tardani95/esp8266-stm32f103c8-ws2811/Documentation/nyak.pdf

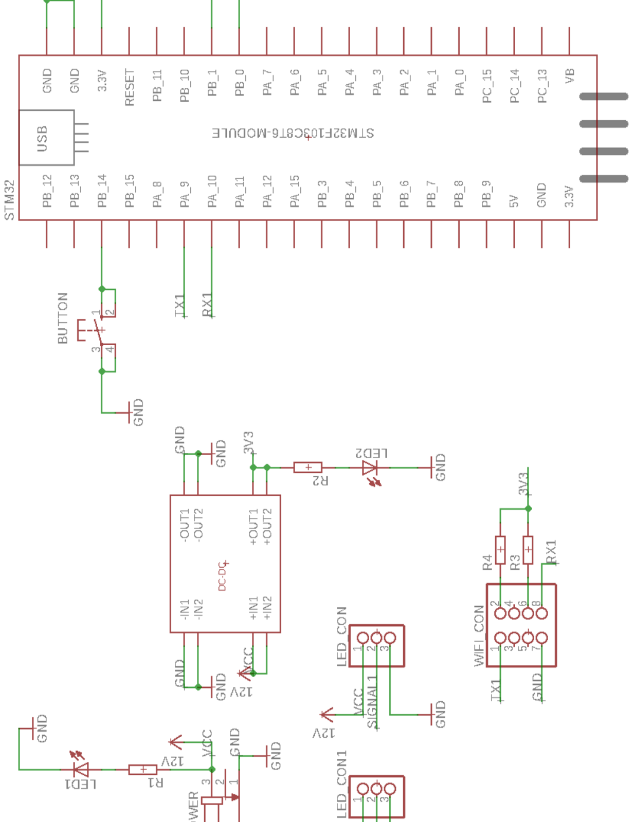
[picture p12: page 1]
