tardani95/esp8266-stm32f103c8-ws2811/doc/esp8266/esp8266_esp01_pinout.png

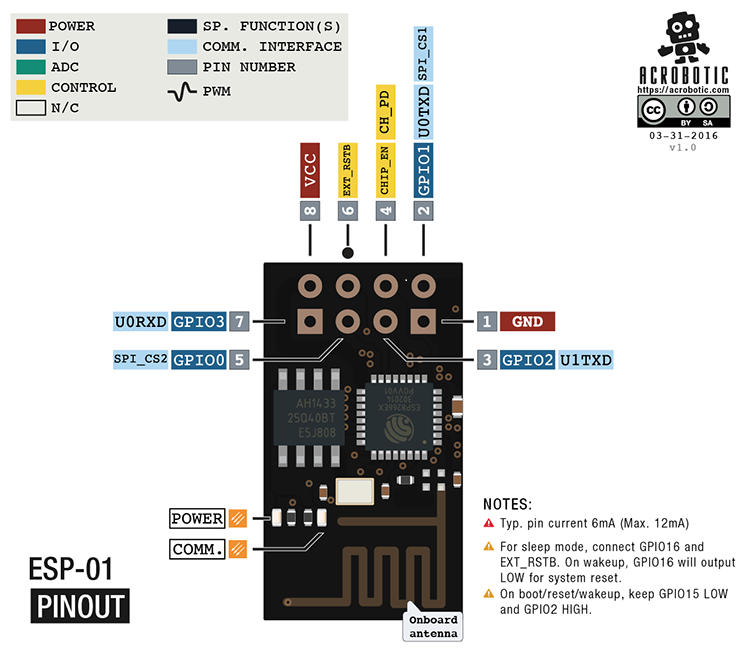
doc/esp8266/esp8266_esp01_pinout.png
