tardani95/esp8266-stm32f103c8-ws2811/doc/stm32f103c8/bd_stm32f103x8_64k.jpg

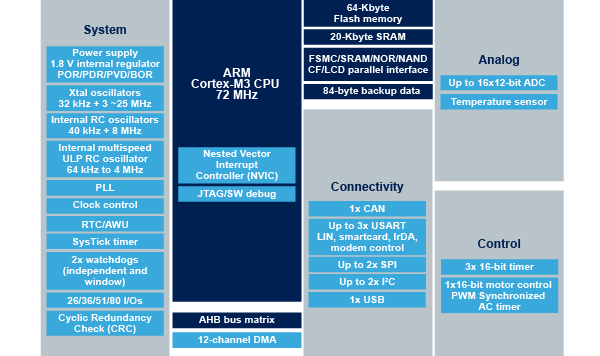
doc/stm32f103c8/bd_stm32f103x8_64k.jpg
