tardani95/esp8266-stm32f103c8-ws2811/doc/stm32f103c8/STM32F103C8.png

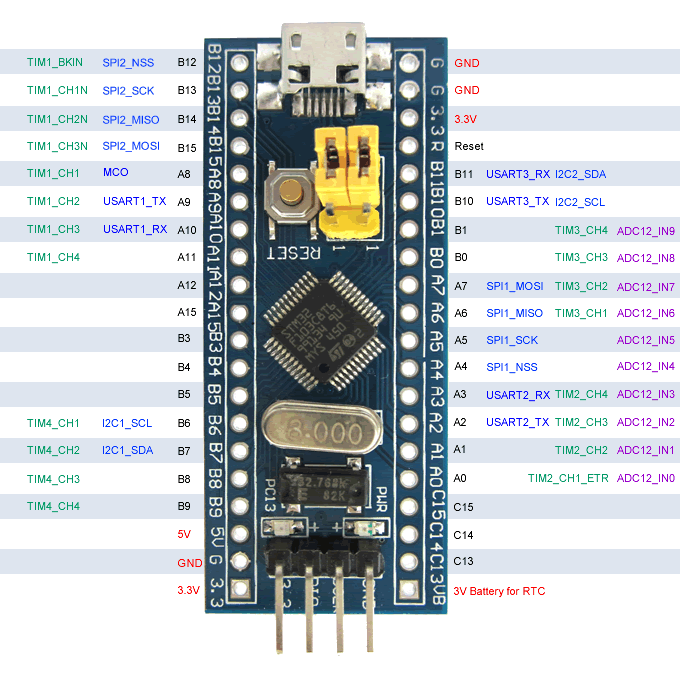
doc/stm32f103c8/STM32F103C8.png
