tardani95/esp8266-stm32f103c8-ws2811/pcb/wifi_ledstrip/bom.xlsx

Sheet: bom_2
 | Total for 4 board | Qty |  | Value | Device | Package | Parts | Description | PROD_ID | SF_ID | SF_SKU | SPICEPREFIX | VALUE
x | 25 | 6 | 0,1u | 100n | C-USC1206 | C1206 | C2, C4, C5, C6, Cbst1,Cbst2 | CAPACITOR, American symbol |  |  |  | C
x | 5 | 1 | 0,01u | 10n | C-USC1206 | C1206 | C9 | CAPACITOR, American symbol |  |  |  | C
x | 5 | 1 | 1u | 1u | C-USC1206 | C1206 | C10 | CAPACITOR, American symbol |  |  |  | C
x1 | 9 | 2 |  | 20p | C-USC1206 | C1206 | C3, C7 | CAPACITOR, American symbol |  |  |  | C
x | 5 | 1 |  | 220u | C-USC1206 | C1206 | C1 | CAPACITOR, American symbol |  |  |  | C
 |  |  |  | nincs ilyen 33u helyette
x1 | 9 | 2 |  | 22u | C-USC1206 | C1206 | CIN1, CIN2 min 12V | CAPACITOR, American symbol |  |  |  | C
x1 | 9 | 2 |  | 22u | C-USC1206 | C1206 | COUT1, COUT2 3v3 | CAPACITOR, American symbol |  |  |  | C
x | 5 | 1 |  | 4.7u | C-USC1206 | C1206 | C_VDD3 | CAPACITOR, American symbol |  |  |  | C
x1 | 9 | 2 |  | 8.2n | C-USC1206 | C1206 | CSS1, CSS2 | CAPACITOR, American symbol |  |  |  | C
x | 13 | 3 |  | 100k | R-US_R1206 | R1206 | R10, RPG1, RPG2 | RESISTOR, American symbol |  |  |  | R
x | 25 | 6 |  | 10k | R-US_R1206 | R1206 | R6, R11, RFBB1, RFBB2, R_EN1, R_EN2 | RESISTOR, American symbol |  |  |  | R
x5 | 5 | 1 |  | 33.2k | R-US_R1206 | R1206 | RFBT1 | RESISTOR, American symbol |  |  |  | R
x5 | 5 | 1 |  | 56.2k | R-US_R1206 | R1206 | RFBT2 | RESISTOR, American symbol |  |  |  | R
xTI | 5 | 1 |  | SN74LV1T34 | SN74LV1T34 | SOT-23-5 | U$2 |  |  |  |  | U
x1 | 9 | 2 |  | SN74LV1T34 | SN74LV1T34 | SOT-23-5 | U$1, U$3
x | 5 | 1 |  | 3.3u | TYS60203R3N-10 | TYS60203R3N-10 | TYS60203R3N-10
x | 5 | 1 |  | 4.7u | SRN4026-4R7M | SRN4026-4R7M | SRN4026-4R7M
x | 5 | 1 |  |  | CONN_025MM | SCREWTERMINAL-5MM-2 | POWER | Multi connection point. Often used as Generic Header-pin footprint for 0.1 inch spaced/style header connections |  |  | PRT-08432
x | 13 | 3 |  |  | CONN_03SCREW | SCREWTERMINAL-3.5MM-3 | LED_STRIP_12V, LED_STRIP_GND, LED_STRIP_SIGNAL | Multi connection point. Often used as Generic Header-pin footprint for 0.1 inch spaced/style header connections | CONN-08288 | PRT-08235
x | 5 | 1 |  |  | CONN_03POLAR | MOLEX-1X3 | PROGRAMMER | Multi connection point. Often used as Generic Header-pin footprint for 0.1 inch spaced/style header connections | CONN-08625 | PRT-08096
x | 5 | 1 |  | 8MHz | XTAL/S | QS | Q1 | CRYSTAL
x | 4 | 2 |  | TPS562219A | TPS562219A | SOT23-8L | PSU_3V3, PSU_5V
x | 5 | 1 |  | STM32F10XCXT6 | STM32F10XCXT6 | TQFP48 | IC1 | ST STM32F101/103 48pin LQFP
x | 15 | 4 |  | TACTILE_SWITCH_SIDETACTILE_SWITCH_SIDE | TACTILE_SWITCH_SIDETACTILE_SWITCH_SIDE | TACTILE_SWITCH_SIDE | SW_3, SW_4, SW_RESET, WIFI_RECONNECT
12v_3v3
Part | Manufacturer | Part Number |  | Quantity | Price | Attribute 1 Name | Attribute 1 Value | Attribute 2 Name | Attribute 2 Value | Attribute 3 Name | Attribute 3 Value | Footprint
L1 | Bourns | SRR4028-3R3Y |  | 1 | 0.31 | L | 3.3uH | DCR | 0.035Ohm | IDC | 1.65A | SRR4028
Cout | TDK | C1608X5R1A226M080AC |  | 1 | 0.13 | Cap | 22uF | ESR | 3.71mOhm | Total Derated Cap | 7.4E-6F | 603
Rfbt | Vishay-Dale | CRCW040233K2FKED |  | 1 | 0.01 | Resistance | 33.2kOhm | Tolerance | 1% | Power | 0.063W | 402
U1 | Texas Instruments | TPS562219DDFR |  | 1 | 0.54 |  |  |  |  |  |  | DDF0008A
Cbst | Kemet | C0603C104Z3VACTU |  | 1 | 0.01 | Cap | 100nF | ESR | 1mOhm | Total Derated Cap | 1.0E-7F | 603
Cin | TDK | C2012X5R1V226M125AC |  | 1 | 0.38 | Cap | 22uF | ESR | 2.05mOhm | Total Derated Cap | 1.4E-5F | 805
Css | MuRata | GRM033R61A822KA01D |  | 1 | 0.01 | Cap | 8.2nF | ESR | 1mOhm | Total Derated Cap | 8.2E-9F | 201
Rfbb | Stackpole Electronics Inc | RMCF0402FT10K0 |  | 1 | 0.01 | Resistance | 10kOhm | Tolerance | 1% | Power | 0.063W | 402
Rpg | Panasonic | ERJ-6ENF1003V |  | 1 | 0.01 | Resistance | 100kOhm | Tolerance | 1% | Power | 0.125W | 805
12v_5v
Part | Manufacturer | Part Number |  | Quantity | Price | Attribute 1 Name | Attribute 1 Value | Attribute 2 Name | Attribute 2 Value | Attribute 3 Name | Attribute 3 Value | Footprint
L1 | Bourns | SRN6045-4R7Y |  | 1 | 0.19 | L | 4.7uH | DCR | 0.038Ohm | IDC | 3A | SRN6045
Cout | TDK | C1608X5R1A226M080AC |  | 1 | 0.13 | Cap | 22uF | ESR | 3.71mOhm | Total Derated Cap | 4.5E-6F | 603
Rfbt | Yageo | RC0201FR-0756K2L |  | 1 | 0.01 | Resistance | 56.2kOhm | Tolerance | 1% | Power | 0.05W | 201
U1 | Texas Instruments | TPS562219DDFR |  | 1 | 0.54 |  |  |  |  |  |  | DDF0008A
Cbst | Kemet | C0603C104Z3VACTU |  | 1 | 0.01 | Cap | 100nF | ESR | 1mOhm | Total Derated Cap | 1.0E-7F | 603
Cin | Nichicon | UUD1H220MCL1GS |  | 1 | 0.09 | Cap | 22uF | ESR | 0.88Ohm | Total Derated Cap | 2.2E-5F | SM_RADIAL_6.3AMM
Css | MuRata | GRM033R61A822KA01D |  | 1 | 0.01 | Cap | 8.2nF | ESR | 1mOhm | Total Derated Cap | 8.2E-9F | 201
Rfbb | Stackpole Electronics Inc | RMCF0402FT10K0 |  | 1 | 0.01 | Resistance | 10kOhm | Tolerance | 1% | Power | 0.063W | 402
Rpg | Panasonic | ERJ-6ENF1003V |  | 1 | 0.01 | Resistance | 100kOhm | Tolerance | 1% | Power | 0.125W | 805
lomex
ledeket kinezni | 33 | 8 |  |  | R-US_R1206 | R1206 | R1, R2, R3, R4, R5, R7, R8, R9 | RESISTOR, American symbol |  |  |  | R
hozza ellenallasok | 33 | 8 |  | GREEN | LED-GREEN1206 | LED-1206 | HEARTBEAT, LED7, LED8, L_3V3, L_5V, L_12V, L_RX, L_TX | Green SMD LED | DIO-00862 |  |  |  | GREEN
 |  |  |  | ellenallasok
ledek | darabszam | feszultseg | aram | 12 V | 5 V | 3.3 V
piros | 10 db | 2.1 V | 20 mA | 495 Ohm | 145 Ohm | 60 Ohm
feher | 10 db | 3 V | 20 mA | 450 Ohm | 100 Ohm | 15 Ohm
sarga | 10 db | 2.1 V | 20 mA | 495 Ohm | 145 Ohm | 60 Ohm
kek | 10 db | 3 V | 20 mA | 450 Ohm | 100 Ohm | 15 Ohm
narancs | 10 db | 2.1 V | 20 mA | 495 Ohm | 145 Ohm | 60 Ohm
ellenallas ledekhez | rendelendo | darabszam
495 Ohm | 510 Ohm | 30 db
450 Ohm | 470 Ohm | 20 db
145 Ohm | 150 Ohm | 30 db
100 Ohm | 100 Ohm | 20 db
60 Ohm | 62 Ohm | 30 db
15 Ohm | 15 Ohm | 20 db

Sheet: bom_12v_3v3
Part | Manufacturer | Part Number | Quantity | Price | Attribute 1 Name | Attribute 1 Value | Attribute 2 Name | Attribute 2 Value | Attribute 3 Name | Attribute 3 Value | Footprint
L1 | Bourns | SRR4028-3R3Y | 1 | 0.31 | L | 3.3uH | DCR | 0.035Ohm | IDC | 1.65A | SRR4028
Cout | TDK | C1608X5R1A226M080AC | 1 | 0.13 | Cap | 22uF | ESR | 3.71mOhm | Total Derated Cap | 7.4E-6F | 603
Rfbt | Vishay-Dale | CRCW040233K2FKED | 1 | 0.01 | Resistance | 33.2kOhm | Tolerance | 1% | Power | 0.063W | 402
U1 | Texas Instruments | TPS562219DDFR | 1 | 0.54 |  |  |  |  |  |  | DDF0008A
Cbst | Kemet | C0603C104Z3VACTU | 1 | 0.01 | Cap | 100nF | ESR | 1mOhm | Total Derated Cap | 1.0E-7F | 603
Cin | TDK | C2012X5R1V226M125AC | 1 | 0.38 | Cap | 22uF | ESR | 2.05mOhm | Total Derated Cap | 1.4E-5F | 805
Css | MuRata | GRM033R61A822KA01D | 1 | 0.01 | Cap | 8.2nF | ESR | 1mOhm | Total Derated Cap | 8.2E-9F | 201
Rfbb | Stackpole Electronics Inc | RMCF0402FT10K0 | 1 | 0.01 | Resistance | 10kOhm | Tolerance | 1% | Power | 0.063W | 402
Rpg | Panasonic | ERJ-6ENF1003V | 1 | 0.01 | Resistance | 100kOhm | Tolerance | 1% | Power | 0.125W | 805

Sheet: bom_12v_5v
Part | Manufacturer | Part Number | Quantity | Price | Attribute 1 Name | Attribute 1 Value | Attribute 2 Name | Attribute 2 Value | Attribute 3 Name | Attribute 3 Value | Footprint
L1 | Bourns | SRN6045-4R7Y | 1 | 0.19 | L | 4.7uH | DCR | 0.038Ohm | IDC | 3A | SRN6045
Cout | TDK | C1608X5R1A226M080AC | 1 | 0.13 | Cap | 22uF | ESR | 3.71mOhm | Total Derated Cap | 4.5E-6F | 603
Rfbt | Yageo | RC0201FR-0756K2L | 1 | 0.01 | Resistance | 56.2kOhm | Tolerance | 1% | Power | 0.05W | 201
U1 | Texas Instruments | TPS562219DDFR | 1 | 0.54 |  |  |  |  |  |  | DDF0008A
Cbst | Kemet | C0603C104Z3VACTU | 1 | 0.01 | Cap | 100nF | ESR | 1mOhm | Total Derated Cap | 1.0E-7F | 603
Cin | Nichicon | UUD1H220MCL1GS | 1 | 0.09 | Cap | 22uF | ESR | 0.88Ohm | Total Derated Cap | 2.2E-5F | SM_RADIAL_6.3AMM
Css | MuRata | GRM033R61A822KA01D | 1 | 0.01 | Cap | 8.2nF | ESR | 1mOhm | Total Derated Cap | 8.2E-9F | 201
Rfbb | Stackpole Electronics Inc | RMCF0402FT10K0 | 1 | 0.01 | Resistance | 10kOhm | Tolerance | 1% | Power | 0.063W | 402
Rpg | Panasonic | ERJ-6ENF1003V | 1 | 0.01 | Resistance | 100kOhm | Tolerance | 1% | Power | 0.125W | 805
