tardani95/esp8266-stm32f103c8-ws2811/pcb/prototype_quick_test/images/board1.png

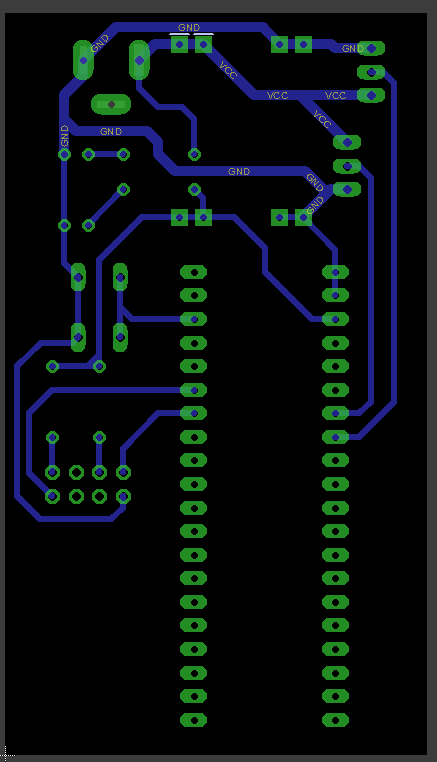
pcb/prototype_quick_test/images/board1.png
