tardani95/esp8266-stm32f103c8-ws2811/pcb/prototype_quick_test/iron2.pdf

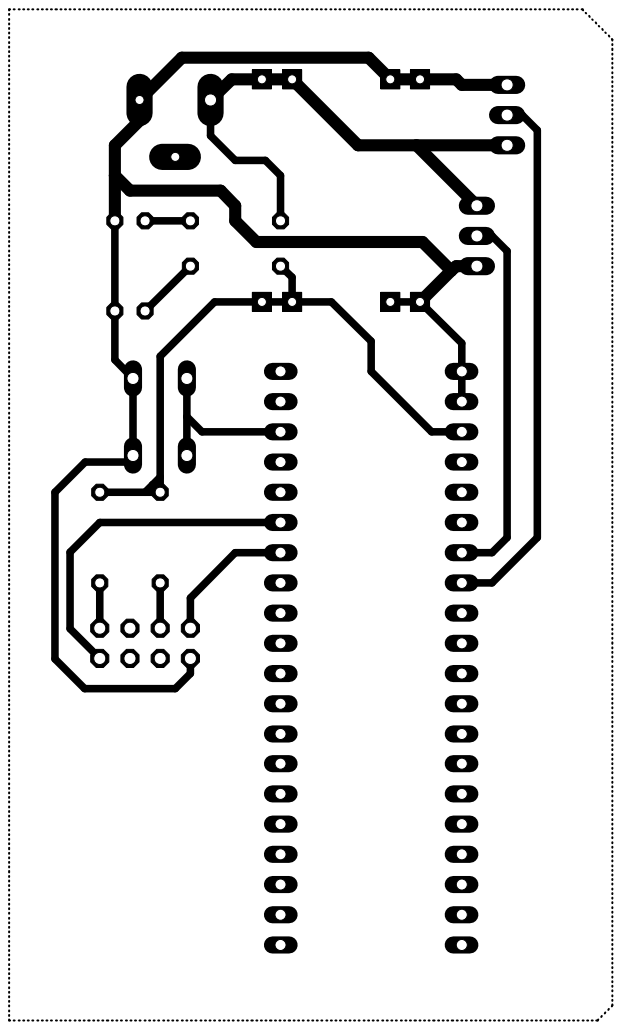
[picture p20: page 1]
