tardani95/esp8266-stm32f103c8-ws2811/pcb/prototype_quick_test/iron3.pdf

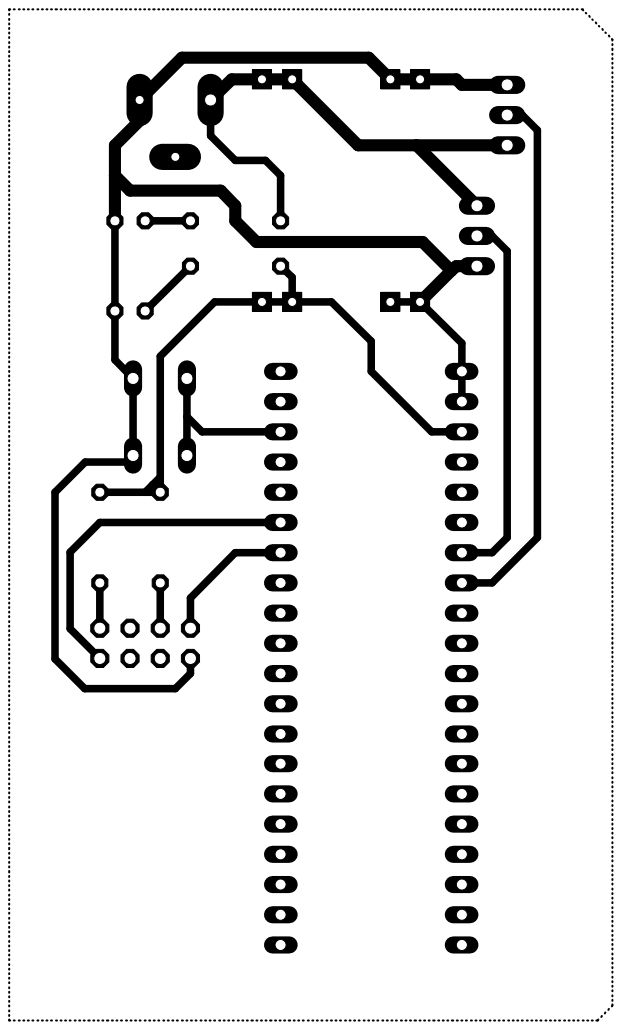
[picture p21: page 1]
