tardani95/esp8266-stm32f103c8-ws2811/Documentation/logo_bme_kicsi-eps-converted-to.pdf

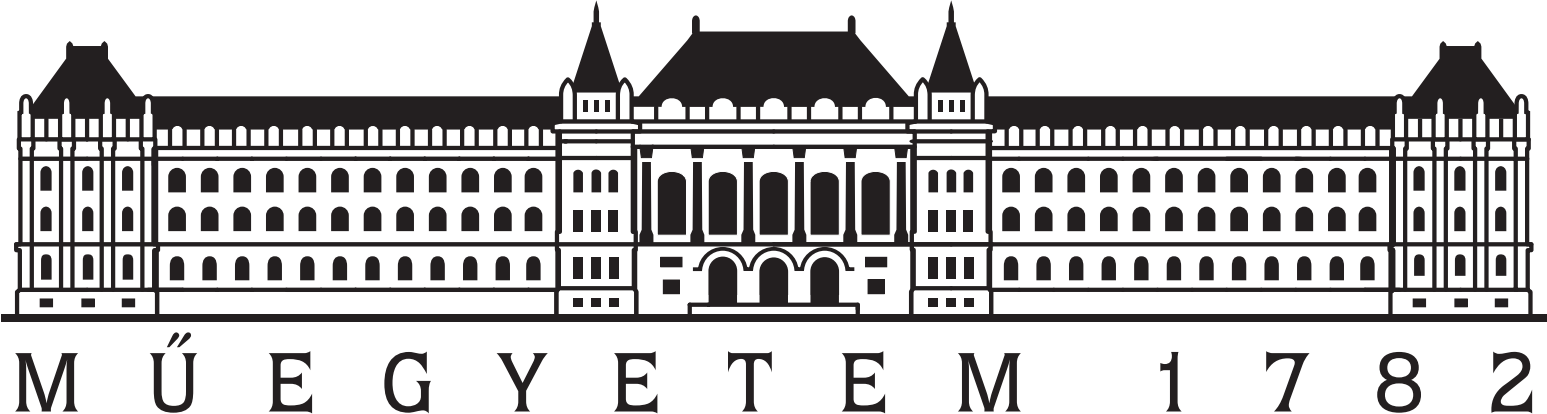
[picture p22: page 1]
