tardani95/esp8266-stm32f103c8-ws2811/pcb/wifi_ledstrip/schematic.brd

## EAGLE design pcb/wifi_ledstrip/schematic.brd (2019-04-17)

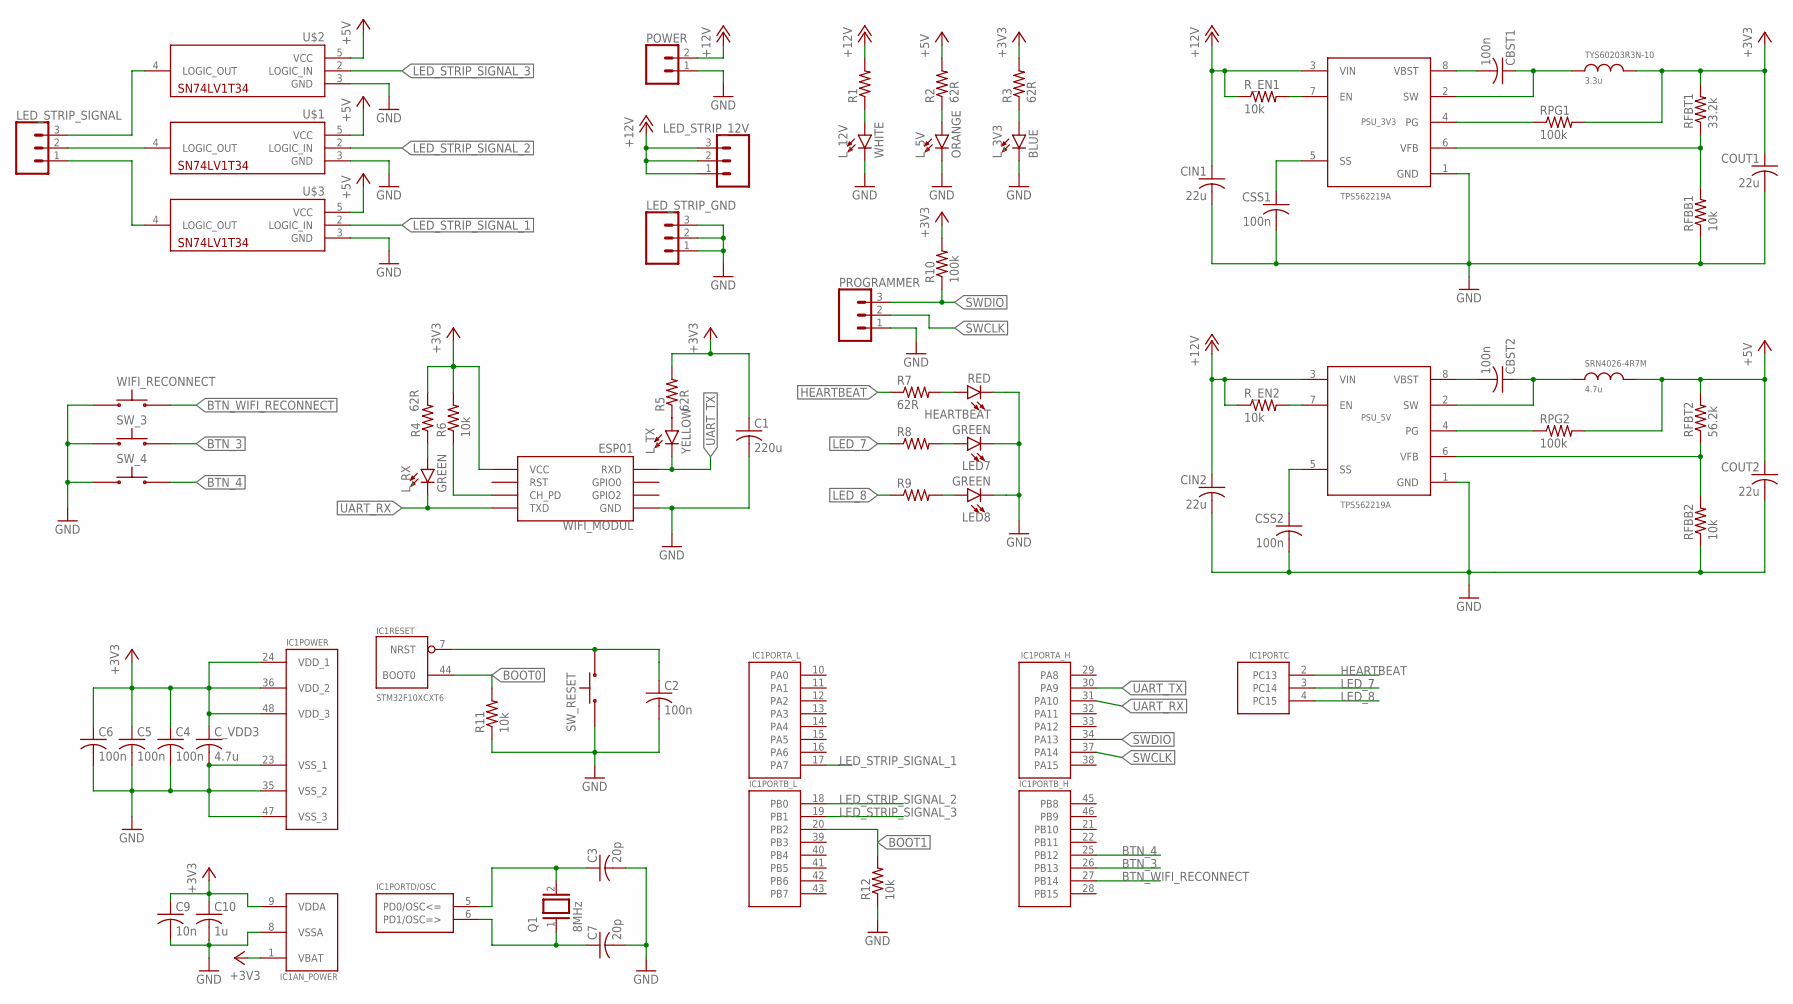
[picture p23: schematic schematic.sch]

Parts:
C1: 220u; C1206
C2, C4, C5, C6: 100n; C1206
C3, C7: 20p; C1206
C9: 10n; C1206
C10: 1u; C1206
CBST1, CBST2: 100n; C1206
CIN1, CIN2: 22u; C1206
COUT1, COUT2: 22u; C1206
CSS1, CSS2: 100n; C1206
C_VDD3: 4.7u; C1206
HEARTBEAT: RED; LED-1206
IC1: STM32F10XCXT6; TQFP48
LED7, LED8: GREEN; LED-1206
LED_STRIP_12V: CONN_03SCREW; SCREWTERMINAL-3.5MM-3
LED_STRIP_GND: CONN_03SCREW; SCREWTERMINAL-3.5MM-3
LED_STRIP_SIGNAL: CONN_03SCREW; SCREWTERMINAL-3.5MM-3
L_3V3: BLUE; LED-1206
L_5V: ORANGE; LED-1206
L_12V: WHITE; LED-1206
L_RX: GREEN; LED-1206
L_TX: YELLOW; LED-1206
POWER: CONN_025MM; SCREWTERMINAL-5MM-2
PROGRAMMER: CONN_03POLAR; MOLEX-1X3
PSU_3V3, PSU_5V: TPS562219A; SOT23-8L
Q1: 8MHz; QS
R1, R8, R9: R-US_R1206; R1206
R2, R3, R4, R5, R7: 62R; R1206
R6, R11, R12: 10k; R1206
R10: 100k; R1206
RFBB1, RFBB2: 10k; R1206
RFBT1: 33.2k; R1206
RFBT2: 56.2k; R1206
RPG1, RPG2: 100k; R1206
R_EN1, R_EN2: 10k; R1206
SRN4026-4R7M: 4.7u; SRN4026-4R7M
SW_3, SW_4: TACTILE_SWITCH_SIDETACTILE_SWITCH_SIDE; TACTILE_SWITCH_SIDE
SW_RESET: TACTILE_SWITCH_SIDETACTILE_SWITCH_SIDE; TACTILE_SWITCH_SIDE
TYS60203R3N-10: 3.3u; TYS60203R3N-10
U$1, U$2, U$3: SN74LV1T34; SOT-23-5
WIFI_MODUL: ESP01
WIFI_RECONNECT: TACTILE_SWITCH_SIDETACTILE_SWITCH_SIDE; TACTILE_SWITCH_SIDE

Connections:
+3V3: C1.1, C4.1, C5.1, C6.1, C9.1, C10.1, COUT1.1, C_VDD3.1, IC1.1 (VBAT), IC1.9 (VDDA), IC1.24 (VDD_1), IC1.36 (VDD_2), IC1.48 (VDD_3), R3.2, R4.2, R5.2, R6.2, R10.2, RFBT1.2, RPG1.2, TYS60203R3N-10.P$2 (2), WIFI_MODUL.VCC
+5V: COUT2.1, R2.2, RFBT2.2, RPG2.2, SRN4026-4R7M.P$3 (2), U$1.5 (VCC), U$2.5 (VCC), U$3.5 (VCC)
+12V: CIN1.1, CIN2.1, LED_STRIP_12V.1, LED_STRIP_12V.2, LED_STRIP_12V.3, POWER.2, PSU_3V3.3 (VIN), PSU_5V.3 (VIN), R1.2, R_EN1.1, R_EN2.1
BOOT0: IC1.44 (BOOT0), R11.2
BOOT1: IC1.20 (PB2), R12.2
BTN_3: IC1.26 (PB13), SW_3.P$5
BTN_4: IC1.25 (PB12), SW_4.P$5
BTN_WIFI_RECONNECT: IC1.27 (PB14), WIFI_RECONNECT.P$5
GND: C1.2, C2.2, C3.2, C4.2, C5.2, C6.2, C7.2, C9.2, C10.2, CIN1.2, CIN2.2, COUT1.2, COUT2.2, CSS1.2, CSS2.2, C_VDD3.2, HEARTBEAT.C, IC1.8 (VSSA), IC1.23 (VSS_1), IC1.35 (VSS_2), IC1.47 (VSS_3), LED7.C, LED8.C, LED_STRIP_GND.1, LED_STRIP_GND.2, LED_STRIP_GND.3, L_3V3.C, L_5V.C, L_12V.C, POWER.1, PROGRAMMER.1, PSU_3V3.1 (GND), PSU_5V.1 (GND), R11.1, R12.1, RFBB1.1, RFBB2.1, SW_3.P$3, SW_4.P$3, SW_RESET.P$5, U$1.3 (GND), U$2.3 (GND), U$3.3 (GND), WIFI_MODUL.GND, WIFI_RECONNECT.P$3
HEARTBEAT: IC1.2 (PC13), R7.1
LED_7: IC1.3 (PC14), R8.1
LED_8: IC1.4 (PC15), R9.1
LED_STRIP_SIGNAL_1: IC1.17 (PA7), U$3.2 (LOGIC_IN)
LED_STRIP_SIGNAL_2: IC1.18 (PB0), U$1.2 (LOGIC_IN)
LED_STRIP_SIGNAL_3: IC1.19 (PB1), U$2.2 (LOGIC_IN)
unnamed: LED_STRIP_SIGNAL.3, U$2.4 (LOGIC_OUT)
unnamed: LED_STRIP_SIGNAL.2, U$1.4 (LOGIC_OUT)
unnamed: LED_STRIP_SIGNAL.1, U$3.4 (LOGIC_OUT)
unnamed: L_12V.A, R1.1
unnamed: L_5V.A, R2.1
unnamed: L_3V3.A, R3.1
unnamed: L_RX.A, R4.1
unnamed: R6.1, WIFI_MODUL.CH_PD
unnamed: L_TX.A, R5.1
unnamed: HEARTBEAT.A, R7.2
unnamed: LED7.A, R8.2
unnamed: LED8.A, R9.2
unnamed: C2.1, IC1.7 (NRST), SW_RESET.P$3
unnamed: C3.1, IC1.5 (PD0/OSC<=), Q1.2
unnamed: C7.1, IC1.6 (PD1/OSC=>), Q1.1
unnamed: CBST1.2, PSU_3V3.8 (VBST)
unnamed: CBST1.1, PSU_3V3.2 (SW), TYS60203R3N-10.P$1 (1)
unnamed: CBST2.2, PSU_5V.8 (VBST)
unnamed: PSU_3V3.6 (VFB), RFBB1.2, RFBT1.1
unnamed: CBST2.1, PSU_5V.2 (SW), SRN4026-4R7M.P$2 (1)
unnamed: PSU_5V.6 (VFB), RFBB2.2, RFBT2.1
unnamed: PSU_3V3.7 (EN), R_EN1.2
unnamed: PSU_5V.7 (EN), R_EN2.2
N$PG1: PSU_3V3.4 (PG), RPG1.1
N$PG2: PSU_5V.4 (PG), RPG2.1
N$SS1: CSS1.1, PSU_3V3.5 (SS)
N$SS2: CSS2.1, PSU_5V.5 (SS)
SWCLK: IC1.37 (PA14), PROGRAMMER.2
SWDIO: IC1.34 (PA13), PROGRAMMER.3, R10.1
UART_RX: IC1.31 (PA10), L_RX.C, WIFI_MODUL.TX (TXD)
UART_TX: IC1.30 (PA9), L_TX.C, WIFI_MODUL.RX (RXD)

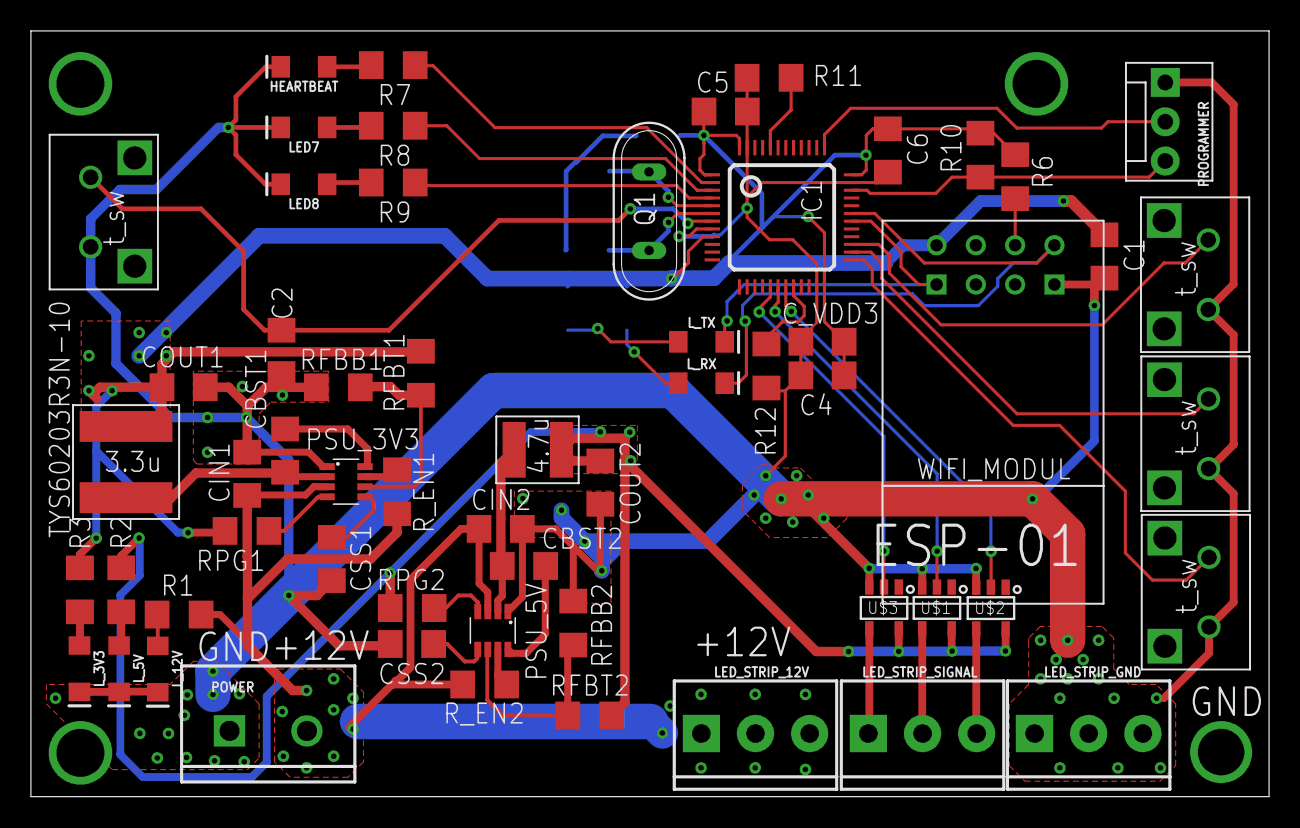
[picture p24: board schematic.brd from above]

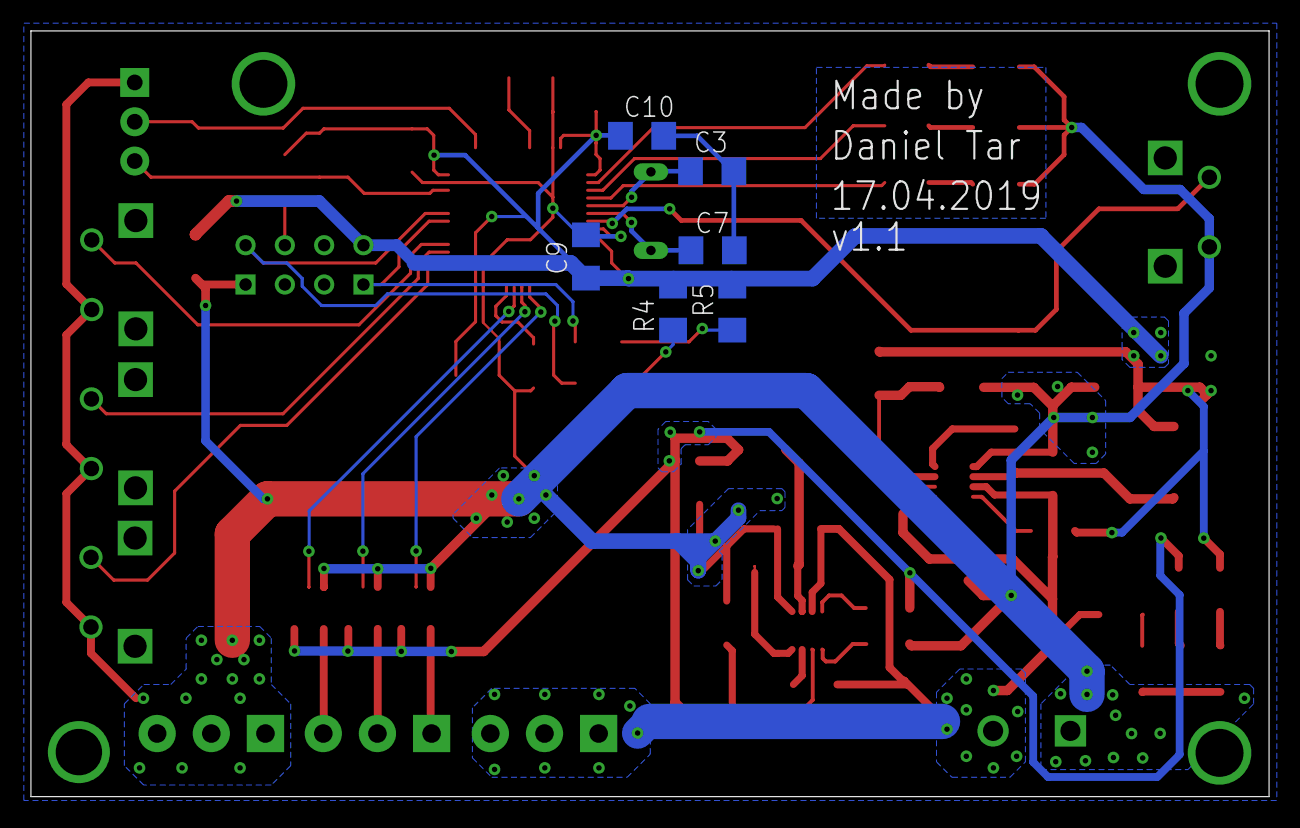
[picture p25: board schematic.brd from below]

Board: 2 copper layers, 80.0 x 49.5 mm, 65 parts (6 on the bottom side), 46 nets.
