tardani95/esp8266-stm32f103c8-ws2811/pcb/prototype_quick_test/ledsor.brd

## EAGLE design pcb/prototype_quick_test/ledsor.brd (2018-05-05)

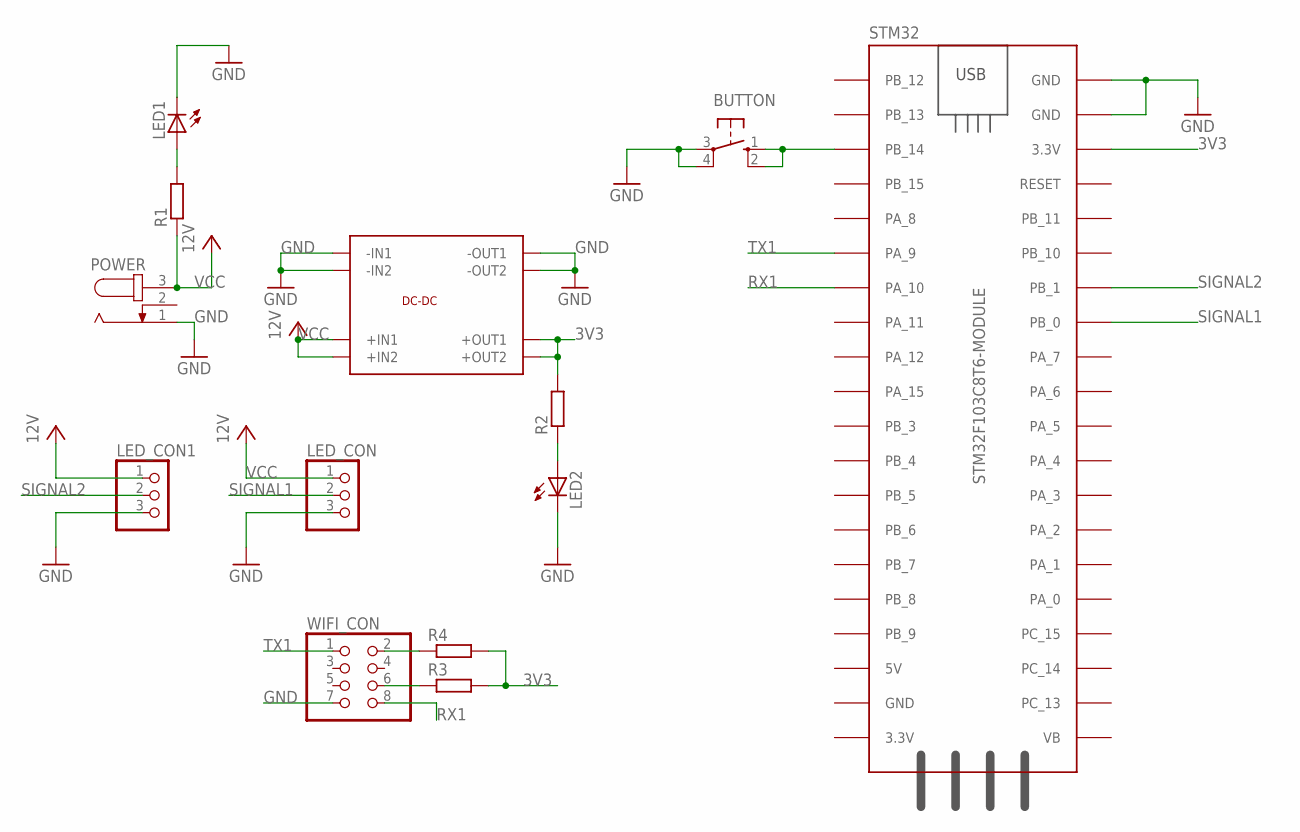
[picture p26: schematic ledsor.sch]

Parts:
BUTTON: 10-XX; B3F-10XX
DC-DC: SDVR_SMALL
LED1, LED2: LED5MM
LED_CON, LED_CON1: PINHD-1X3; 1X03
POWER: JACK-PLUG1; SPC4078
R1, R2, R3, R4: R-EU_0204/7; 0204/7
STM32: STM32F103C8T6-MODULE
WIFI_CON: PINHD-2X4; 2X04

Connections:
3V3: DC-DC.P$7 (+OUT1), DC-DC.P$8 (+OUT2), R2.2, R3.2, R4.2, STM32.3.3V_2 (3.3V)
GND: BUTTON.3, BUTTON.4 (P1), DC-DC.P$1 (-IN1), DC-DC.P$2 (-IN2), DC-DC.P$5 (-OUT1), DC-DC.P$6 (-OUT2), LED1.K (C), LED2.K (C), LED_CON.3, LED_CON1.3, POWER.1, STM32.GND_2 (GND), STM32.GND_3 (GND), WIFI_CON.7
unnamed: LED1.A, R1.2
unnamed: R3.1, WIFI_CON.6
unnamed: LED2.A, R2.1
unnamed: R4.1, WIFI_CON.2
unnamed: BUTTON.1 (S), BUTTON.2 (S1), STM32.PB_14
RX1: STM32.PA_10, WIFI_CON.8
SIGNAL1: LED_CON.2, STM32.PB_0
SIGNAL2: LED_CON1.2, STM32.PB_1
TX1: STM32.PA_9, WIFI_CON.1
VCC: DC-DC.P$3 (+IN1), DC-DC.P$4 (+IN2), LED_CON.1, LED_CON1.1, POWER.3, R1.1

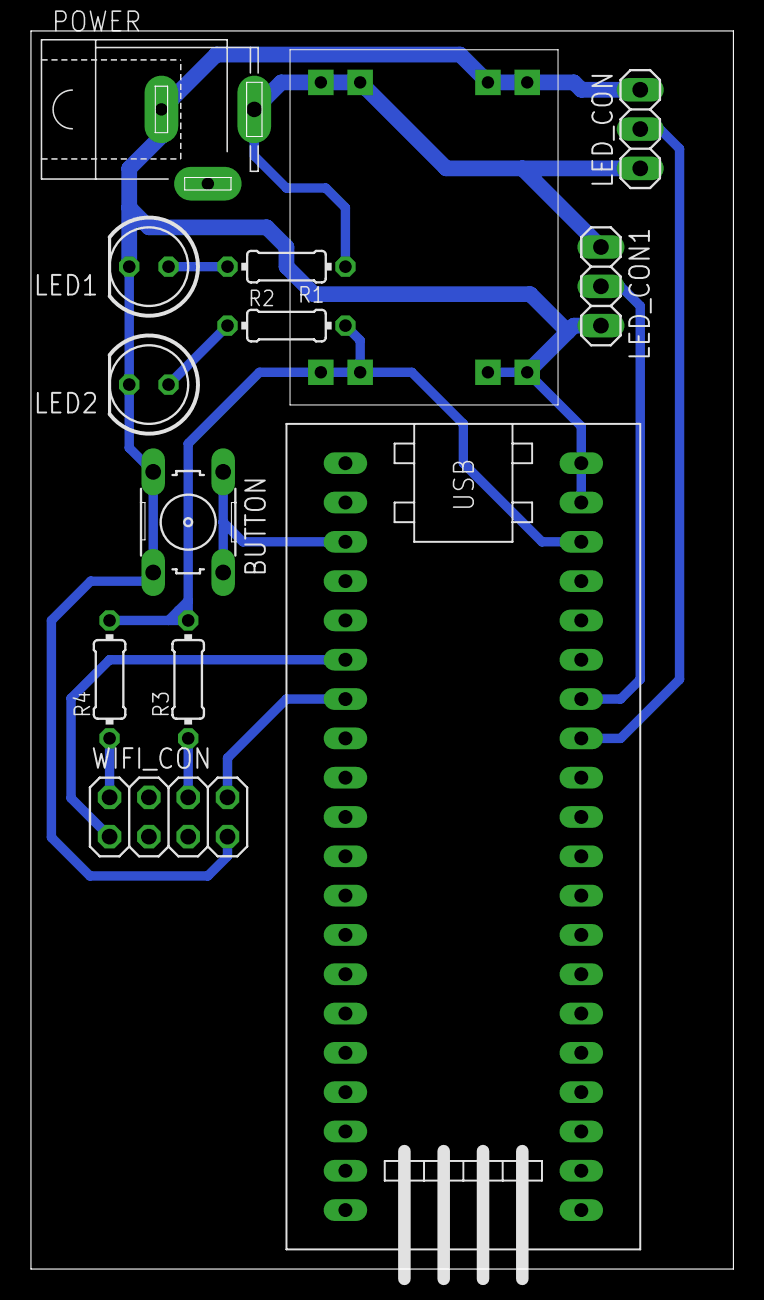
[picture p27: board ledsor.brd from above]

Board: 2 copper layers, 45.4 x 80.0 mm, 13 parts (0 on the bottom side), 12 nets.
