tardani95/esp8266-stm32f103c8-ws2811/my_libs/ws2811.c

/*
 ******************************************************************************
 File        : ws2811.c
 Author      : Daniel Tar - ideas based on Peter Vass implementation
 Version     :
 Copyright   :
 Description : ws2811 library for stm32f103c8 microcontroller
 Info        : 16.06.2018
 *******************************************************************************
 */

/******************************************************************************/
/*                               Includes									  */
/******************************************************************************/
#include "ws2811.h"
#include "ws2811_util.h" /* for fillPattern method in Init_PixelMap function */
#include "util.h"
/******************************************************************************/
/*                             Debug options								  */
/******************************************************************************/
//#define DEBUG_PINS_ON
//#define DEBUG_DMA_BUFFER_FILL_UP
//#define DEBUG_DMA_BUFFER_IRQ
//#define DEBUG_DMA_BUFFER_HT
//#define DEBUG_DMA_BUFFER_TC
/******************************************************************************/
/*                          Private variables                                 */
/******************************************************************************/

/* gamma correction table - by Peter Vass */
const uint8_t gammaCorrectionTable[] = { 0, 0, 0, 0, 0, 0, 0, 0, 0, 0, 0, 0, 0,
		0, 0, 0, 0, 0, 0, 0, 0, 0, 0, 0, 0, 0, 0, 0, 1, 1, 1, 1, 1, 1, 1, 1, 1,
		1, 1, 1, 1, 2, 2, 2, 2, 2, 2, 2, 2, 3, 3, 3, 3, 3, 3, 3, 4, 4, 4, 4, 4,
		5, 5, 5, 5, 6, 6, 6, 6, 7, 7, 7, 7, 8, 8, 8, 9, 9, 9, 10, 10, 10, 11,
		11, 11, 12, 12, 13, 13, 13, 14, 14, 15, 15, 16, 16, 17, 17, 18, 18, 19,
		19, 20, 20, 21, 21, 22, 22, 23, 24, 24, 25, 25, 26, 27, 27, 28, 29, 29,
		30, 31, 32, 32, 33, 34, 35, 35, 36, 37, 38, 39, 39, 40, 41, 42, 43, 44,
		45, 46, 47, 48, 49, 50, 50, 51, 52, 54, 55, 56, 57, 58, 59, 60, 61, 62,
		63, 64, 66, 67, 68, 69, 70, 72, 73, 74, 75, 77, 78, 79, 81, 82, 83, 85,
		86, 87, 89, 90, 92, 93, 95, 96, 98, 99, 101, 102, 104, 105, 107, 109,
		110, 112, 114, 115, 117, 119, 120, 122, 124, 126, 127, 129, 131, 133,
		135, 137, 138, 140, 142, 144, 146, 148, 150, 152, 154, 156, 158, 160,
		162, 164, 167, 169, 171, 173, 175, 177, 180, 182, 184, 186, 189, 191,
		193, 196, 198, 200, 203, 205, 208, 210, 213, 215, 218, 220, 223, 225,
		228, 231, 233, 236, 239, 241, 244, 247, 249, 252, 255 };

__IO uint8_t TIMx_OC_DMA_Buffer_BRG[DMA_BUFFER_SIZE]; /* DMA buffer for TIMx OutputCompare (OC) values */
__IO ColorRGB pixel_map[LED_STRIP_SIZE][PARALELL_STRIPS]; /* array to store all the pixel colors */

__IO uint16_t pixel_id = 0; /* current processed pixel on the strip */
__IO uint8_t txOn = 0; /* set to 1 if the led strip is refreshing */

uint16_t offset_length_values[2 * PARALELL_STRIPS];

/******************************************************************************/
/*                    Callback function declaration                           */
/******************************************************************************/

/******************************************************************************/
/*                          Function definitions                              */
/******************************************************************************/

/**
 * @brief  This function initialize the WS2811 LED strip
 * @param  @TODO - extend parameter list
 * @retval None
 */
void Init_WS2811(uint8_t * ptr_command_array, uint8_t command_array_size) {

	GPIO_InitTypeDef GPIO_InitStructure;
	NVIC_InitTypeDef NVIC_InitStructure; /* nested vector interrupt controller init */
	TIM_TimeBaseInitTypeDef TIM_TimeBase_InitStructure; /* timer init */
	TIM_OCInitTypeDef TIM_OC_InitStructure; /* output compare init */
	DMA_InitTypeDef DMA_InitStructure; /* dma init  */

	/* ledstrip signal pin init*/
	InitGPIO_LSSs(&GPIO_InitStructure);
	InitNVIC_LSS(&NVIC_InitStructure);

	/* tim3 clock init */
	InitTIM3_CLK(&TIM_TimeBase_InitStructure);
	InitTIM3_PWM(&TIM_OC_InitStructure);
	InitDMA_CH3_TIM3_CHs(&DMA_InitStructure, (uint8_t*) TIMx_OC_DMA_Buffer_BRG); /* look_up_table_1 */

	InitOffsetLengthValues();
}

void InitOffsetLengthValues() {
	for (uint8_t i = 0; i < 2 * PARALELL_STRIPS; i = i + 2) {
		offset_length_values[i] = 0;				// offset
		offset_length_values[i + 1] = LED_STRIP_SIZE;	// length
	}
}

void setOffsetLengthValues(uint16_t *array) {
	for (uint8_t i = 0; i < 2 * PARALELL_STRIPS; i = i + 2) {
		offset_length_values[i] = array[i];		// offset
		offset_length_values[i + 1] = array[i + 1];	// length
	}
}

void getOffsetLengthValues(uint16_t *array) {
	for (uint8_t i = 0; i < 2 * PARALELL_STRIPS; ++i) {
		array[i] = offset_length_values[i];
	};
}

/**
 * @brief  This function corrects the LED color to light with true RGB values
 * @param  color	the color to correct
 * @retval gamma corrected color
 */
uint8_t gammaCorrection(uint8_t color) {
	return gammaCorrectionTable[color];
}
ColorHex gammaCorrHEX(ColorHex color) {
	ColorRGB newColor = colorHexToRGB(color);
	newColor.r = gammaCorrection(newColor.r);
	newColor.g = gammaCorrection(newColor.g);
	newColor.b = gammaCorrection(newColor.b);

	return colorRGBToHex(newColor);
}
ColorRGB gammaCorrRGB(ColorRGB color) {
	ColorRGB newColor;
	newColor.r = gammaCorrection(color.r);
	newColor.g = gammaCorrection(color.g);
	newColor.b = gammaCorrection(color.b);
	return newColor;
}

/* color convert functions */
ColorHex colorToHex(uint8_t red, uint8_t green, uint8_t blue) {
	ColorHex color = EMPTY_COLOR;
	color |= ((red << RED_S) & RED);
	color |= ((green << GREEN_S) & GREEN);
	color |= (blue & BLUE);

	return color;
}
ColorRGB colorToRGB(uint8_t red, uint8_t green, uint8_t blue) {
	ColorRGB color;
	color.r = red;
	color.g = green;
	color.b = blue;

	return color;
}
ColorHex colorRGBToHex(ColorRGB color) {
	ColorHex colorHex = EMPTY_COLOR;
	colorHex |= ((color.r << RED_S) & RED);
	colorHex |= ((color.g << GREEN_S) & GREEN);
	colorHex |= ((color.b & BLUE));

	return colorHex;
}
ColorRGB colorHexToRGB(ColorHex color) {
	ColorRGB colorRGB;

	colorRGB.r = ((color & RED) >> RED_S);
	colorRGB.g = ((color & GREEN) >> GREEN_S);
	colorRGB.b = ((color & BLUE));

	return colorRGB;
}

/* setters and getters */
void setPixelColorHex(uint16_t pxNr, uint8_t parallelLedStripID, ColorHex color) {
	ColorRGB newColor = colorHexToRGB(color);
	pixel_map[pxNr][parallelLedStripID] = newColor;
}
void setPixelColorRGB(uint16_t pxNr, uint8_t parallelLedStripID,
		ColorRGB pxColor) {
//	if (50 <= pxNr) {
//		setPixelColor(pxNr, parallelLedStripID, pxColor.r, pxColor.b,
//				pxColor.g);
//	} else {
		pixel_map[pxNr][parallelLedStripID] = pxColor;
//	}
}
void setPixelColor(uint16_t pxNr, uint8_t parallelLedStripID, uint8_t red,
		uint8_t green, uint8_t blue) {
	pixel_map[pxNr][parallelLedStripID].r = red;
	pixel_map[pxNr][parallelLedStripID].g = green;
	pixel_map[pxNr][parallelLedStripID].b = blue;
}

ColorHex getPixelColorHex(uint16_t pxNr, uint8_t parallelLedStripID) {
	return colorRGBToHex(pixel_map[pxNr][parallelLedStripID]);
}
ColorRGB getPixelColorRGB(uint16_t pxNr, uint8_t parallelLedStripID) {
	return pixel_map[pxNr][parallelLedStripID];
}

void setAllPixelColorHexOnLedStrip(uint8_t parallelLedStripID, ColorHex pxColor) {

	uint16_t offset = offset_length_values[parallelLedStripID * 2];
	uint16_t until = offset + offset_length_values[parallelLedStripID * 2 + 1];
	until = until < LED_STRIP_SIZE ? until : LED_STRIP_SIZE;

	for (uint16_t pxID = offset; pxID < until; ++pxID) {
		setPixelColorHex(pxID, parallelLedStripID, pxColor);
	}
}
void setAllPixelColorRGBOnLedStrip(uint8_t parallelLedStripID, ColorRGB pxColor) {

	uint16_t offset = offset_length_values[parallelLedStripID * 2];
	uint16_t until = offset + offset_length_values[parallelLedStripID * 2 + 1];
	until = until < LED_STRIP_SIZE ? until : LED_STRIP_SIZE;

	for (uint16_t pxID = offset; pxID < until; ++pxID) {
		setPixelColorRGB(pxID, parallelLedStripID, pxColor);
	}
}
void setAllPixelColorOnLedStrip(uint8_t parallelLedStripID, uint8_t red,
		uint8_t green, uint8_t blue) {

	uint16_t offset = offset_length_values[parallelLedStripID * 2];
	uint16_t until = offset + offset_length_values[parallelLedStripID * 2 + 1];
	until = until < LED_STRIP_SIZE ? until : LED_STRIP_SIZE;

	for (uint16_t pxID = offset; pxID < until; ++pxID) {
		setPixelColor(pxID, parallelLedStripID, red, green, blue);
	}
}

/**
 * @brief  This function initialize updates the pixel_map with the initial color palette [id=0]
 * @param  None
 * @retval None
 */
void Init_PixelMap(void) {
	fillPattern(1); // id = 1
}

void Clear_PixelMap(void) {
	fillPattern(0); // id = 1
}

/**
 * @brief  This function clears the buffer at the pixel_idx position
 * @param  pixel_idx	position where to clear the buffer
 * @retval None
 */
void Clear_DMA_Buffer(uint16_t pixel_idx) {
	uint16_t id0 = (pixel_idx % PIXEL_PER_BUFFER) * DMA_PIXEL_SIZE;
	uint16_t id1;
	uint16_t id2;
	for (uint8_t colorID = 0; colorID < COLOR_NUM; ++colorID) {
		id1 = colorID * BITS_PER_COLOR;
		for (uint8_t colorBit = 0; colorBit < COLOR_BITS; ++colorBit) {
			id2 = colorBit * PARALELL_STRIPS;
			for (uint8_t parallelStripID = 0; parallelStripID < PARALELL_STRIPS;
					++parallelStripID) {
				TIMx_OC_DMA_Buffer_BRG[id0 + id1 + id2 + parallelStripID] = 0;
			}
		}
	}
}

/**
 * @brief  Fills up the dma buffer section with the pixel_idx data
 * @param  pixel_idx	color data at this pixel
 * @retval None
 */
void FillUp_DMA_Buffer(uint16_t pixel_idx) {

#ifdef DEBUG_DMA_BUFFER_FILL_UP
	GPIOC->ODR &= (~GPIO_Pin_13);
#endif
	ColorRGB gCC; /* gamma corrected color*/
	uint16_t errorCounter = 0;

	uint16_t pxOffset = (pixel_idx % PIXEL_PER_BUFFER) * DMA_PIXEL_SIZE;
	uint16_t colorOffset;
	uint16_t parallelStripOffset;
	for (uint8_t parallelStripID = 0; parallelStripID < PARALELL_STRIPS;
			++parallelStripID) {
		gCC = gammaCorrRGB(getPixelColorRGB(pixel_idx, parallelStripID));
		for (uint8_t colorID = 0; colorID < COLOR_NUM; ++colorID) {
			colorOffset = colorID * BITS_PER_COLOR;
			for (uint8_t colorBit = 0; colorBit < COLOR_BITS; ++colorBit) {
				parallelStripOffset = colorBit * PARALELL_STRIPS;
				switch (colorID) {
				case R: {
					TIMx_OC_DMA_Buffer_BRG[pxOffset + colorOffset
							+ parallelStripOffset + parallelStripID] =
							(gCC.r & (0x80 >> colorBit)) ? T1H : T0H;
					break;
				}
				case G: {
					TIMx_OC_DMA_Buffer_BRG[pxOffset + colorOffset
							+ parallelStripOffset + parallelStripID] =
							(gCC.g & (0x80 >> colorBit)) ? T1H : T0H;
					break;
				}
				case B: {
					TIMx_OC_DMA_Buffer_BRG[pxOffset + colorOffset
							+ parallelStripOffset + parallelStripID] =
							(gCC.b & (0x80 >> colorBit)) ? T1H : T0H;
					break;
				}
				default: {
					/*something not working correctly*/
					errorCounter++;
					break;
				}
				}
			}
		}
	}
#ifdef DEBUG_DMA_BUFFER_FILL_UP
	GPIOC->ODR |= (GPIO_Pin_13);
#endif
}

/**
 * @brief  This function initialize the first whole DMA Buffer
 * @param  None
 * @retval None
 */
void Init_DMA_Buffer(void) {
	pixel_id = 0;
	for (uint8_t buff_px = 0; buff_px < PIXEL_PER_BUFFER; buff_px++) {
		FillUp_DMA_Buffer(pixel_id + buff_px);
	}
	pixel_id = PIXEL_PER_BUFFER / 2;
}

/**
 * @brief  Sends out the color data to the led strip:
 * 		- disables the TIM, sets its CCRx register values to 0
 * 		- set the DMA data counter
 * 		- initialize the buffer and pixel_id variables
 * 		- set the transmission flag to ON
 * 		- clear the DMA Flags
 * 		- enable the DMA and TIM controllers
 * @param  None
 * @retval None
 */
void refreshLedStrip(void) {

	TIM_Cmd(TIM3, DISABLE);
	DMA_Cmd(DMA1_Channel3, DISABLE);
	DMA_SetCurrDataCounter(DMA1_Channel3, DMA_BUFFER_SIZE);

	/* buffer initialization*/
	Init_DMA_Buffer();
	txOn = 1;

	DMA_ClearFlag(DMA1_FLAG_HT3);
	DMA_ClearFlag(DMA1_FLAG_TC3);
	DMA_Cmd(DMA1_Channel3, ENABLE);
	TIM_Cmd(TIM3, ENABLE);
}

/* DMA circular buffer handling IRQ */
void DMA1_Channel3_IRQHandler(void) {

#ifdef DEBUG_DMA_BUFFER_IRQ
	GPIOC->ODR &= (~GPIO_Pin_13);
#endif

	/* Half transfer */
	if (DMA_GetFlagStatus(DMA1_FLAG_HT3) != RESET) {
#ifdef DEBUG_DMA_BUFFER_HT
		GPIOC->ODR ^= (GPIO_Pin_14); // half transfer flag set
#endif

		DMA_ClearFlag(DMA1_FLAG_HT3);
		pixel_id += PIXEL_PER_BUFFER / 2; /* PIXEL_PER_BUFFER/2 pixel sent out */

	} /* endif - Half transfer */

	/* Transfer Complete */
	if (DMA_GetFlagStatus(DMA1_FLAG_TC3) != RESET) {
#ifdef DEBUG_DMA_BUFFER_TC
		GPIOC->ODR ^= (GPIO_Pin_15); // transfer complete flag set
#endif

		DMA_ClearFlag(DMA1_FLAG_TC3);
		pixel_id += PIXEL_PER_BUFFER / 2; /* PIXEL_PER_BUFFER/2 pixel sent out */

	} /* endif - Transfer complete */

	/* filling up the next half of the buffer with new data */
	if (pixel_id + PIXEL_PER_BUFFER / 2 <= LED_STRIP_SIZE) {
		for (uint8_t buff_px = 0; buff_px < PIXEL_PER_BUFFER / 2; buff_px++) {
			FillUp_DMA_Buffer(pixel_id + buff_px);
		}
	} else if (pixel_id - PIXEL_PER_BUFFER / 2 <= LED_STRIP_SIZE) {
		for (uint8_t buff_px = 0; buff_px < PIXEL_PER_BUFFER / 2; buff_px++) {
			Clear_DMA_Buffer(pixel_id + buff_px);
		}
	} else {
		DMA_Cmd(DMA1_Channel3, DISABLE);
		TIM3->CCR1 = 0;
		TIM3->CCR2 = 0;
		TIM3->CCR3 = 0;
		TIM3->CCR4 = 0;
		for (uint8_t buff_px = 0; buff_px < PIXEL_PER_BUFFER; buff_px++) {
			Clear_DMA_Buffer(buff_px);
		}
		txOn = 0;
		TIM_Cmd(TIM3, DISABLE);
	}

#ifdef DEBUG_DMA_BUFFER_IRQ
	GPIOC->ODR |= (GPIO_Pin_13);
#endif

#ifdef DEBUG_DMA_BUFFER_HT
	GPIOC->ODR &= (~GPIO_Pin_14);
#endif

#ifdef DEBUG_DMA_BUFFER_TC
	GPIOC->ODR &= (~GPIO_Pin_15);
#endif

}

/******************************************************************************/
/*                    Initializer function definitions                        */
/******************************************************************************/

/**
 * @brief  This function initialize the led strip signals on PA7, PB0, PB1
 * @param  GPIO_InitTypeDef variable address
 * @retval None
 */
void InitGPIO_LSSs(GPIO_InitTypeDef* GPIO_InitStructure) {

	uint16_t ledstrip_signal1 = GPIO_Pin_7; /* PA7  */
	uint16_t ledstrip_signal2 = GPIO_Pin_0; /* PB0  */
	uint16_t ledstrip_signal3 = GPIO_Pin_1; /* PB1  */

	RCC_APB2PeriphClockCmd(
	RCC_APB2Periph_GPIOA | RCC_APB2Periph_GPIOB | RCC_APB2Periph_AFIO, ENABLE);

	/* PA7  */
	GPIO_InitStructure->GPIO_Pin = ledstrip_signal1;
	GPIO_InitStructure->GPIO_Mode = GPIO_Mode_AF_PP;
	GPIO_InitStructure->GPIO_Speed = GPIO_Speed_10MHz;
	GPIO_Init(GPIOA, GPIO_InitStructure); /* !GPIOA! */

	/* PB0 & PB1  */
	GPIO_InitStructure->GPIO_Pin = ledstrip_signal2 | ledstrip_signal3;
	GPIO_InitStructure->GPIO_Mode = GPIO_Mode_AF_PP;
	GPIO_InitStructure->GPIO_Speed = GPIO_Speed_10MHz;
	GPIO_Init(GPIOB, GPIO_InitStructure); /* !GPIOB! */

#ifdef DEBUG_PINS_ON
	RCC_APB2PeriphClockCmd(RCC_APB2Periph_GPIOC, ENABLE);

	/* PC14 & PC15  */
	GPIO_InitStructure->GPIO_Pin = GPIO_Pin_14 | GPIO_Pin_15;
	GPIO_InitStructure->GPIO_Mode = GPIO_Mode_Out_PP;
	GPIO_InitStructure->GPIO_Speed = GPIO_Speed_10MHz;
	GPIO_Init(GPIOC, GPIO_InitStructure); /* !GPIOC! */

	GPIO_ResetBits(GPIOC,GPIO_Pin_14 | GPIO_Pin_15);
#endif

}

/**
 * @brief  This function initialize the nested vectored interrupt controller for the DMA CH3 - TIM3
 * @param  NVIC_InitTypeDef variable
 * @retval None
 */
void InitNVIC_LSS(NVIC_InitTypeDef* NVIC_InitStructure) {
	/* DMA1 CH3 - TIM3 OC*/
	NVIC_InitStructure->NVIC_IRQChannel = DMA1_Channel3_IRQn;
	NVIC_InitStructure->NVIC_IRQChannelPreemptionPriority = 1;
	NVIC_InitStructure->NVIC_IRQChannelSubPriority = 0;
	NVIC_InitStructure->NVIC_IRQChannelCmd = ENABLE;
	NVIC_Init(NVIC_InitStructure);
}

/**
 * @brief  This function initialize TIM3 clock to a 800/400kHz frequency - 1.25/2.5us time constant
 *         depends on the prescaler value
 * @param  TIM_TimeBaseInitTypeDef variable address
 * @retval None
 */
void InitTIM3_CLK(TIM_TimeBaseInitTypeDef* TIM_TimeBase_InitStructure) {
	RCC_APB1PeriphClockCmd(RCC_APB1Periph_TIM3, ENABLE);

	TIM_TimeBaseStructInit(TIM_TimeBase_InitStructure);

	TIM_TimeBase_InitStructure->TIM_ClockDivision = TIM_CKD_DIV1;
	TIM_TimeBase_InitStructure->TIM_CounterMode = TIM_CounterMode_Up;
	TIM_TimeBase_InitStructure->TIM_Period = TIM_PERIOD - 1;
	TIM_TimeBase_InitStructure->TIM_Prescaler = TIM_PRESCALER; // divider = prescaler + 1
	TIM_TimeBaseInit(TIM3, TIM_TimeBase_InitStructure);
}

/**
 * @brief  This function initialize TIM3 output compare mode to pwm1 on ch2, ch3, ch4
 * @param  TIM_OCInitTypeDef variable address
 * @retval None
 */
void InitTIM3_PWM(TIM_OCInitTypeDef* TIM_OC_InitStructure) {
	TIM_OCStructInit(TIM_OC_InitStructure);

	TIM_OC_InitStructure->TIM_OCMode = TIM_OCMode_PWM1;
	TIM_OC_InitStructure->TIM_OCIdleState = TIM_OCIdleState_Reset;
	TIM_OC_InitStructure->TIM_OCPolarity = TIM_OCPolarity_High;
	TIM_OC_InitStructure->TIM_OutputState = TIM_OutputState_Enable;
	TIM_OC_InitStructure->TIM_Pulse = 0x0000;

	TIM_OC2Init(TIM3, TIM_OC_InitStructure);
	TIM_OC2PreloadConfig(TIM3, TIM_OCPreload_Enable);

	TIM_OC3Init(TIM3, TIM_OC_InitStructure);
	TIM_OC3PreloadConfig(TIM3, TIM_OCPreload_Enable);

	TIM_OC4Init(TIM3, TIM_OC_InitStructure);
	TIM_OC4PreloadConfig(TIM3, TIM_OCPreload_Enable);

	/* Enable the TIM Counter */
	/* TIM_Cmd(TIM3, ENABLE); */
}

/**
 * @brief  This function initialize the DMA controller for the TIM3 OC values
 * 		from CH2 to CH4 (PA7 PB0 PB1)
 * 		Initialize TIMx (TIM3) first
 * @param  DMA_InitTypeDef variable
 * @param  ledstrip_transmit_dma_buffer - uint8_t[] buffer to send
 * @retval None
 */
void InitDMA_CH3_TIM3_CHs(DMA_InitTypeDef* DMA_InitStructure,
		uint8_t* ledstrip_transmit_dma_buffer) {
	/* DMA 1, Channel 2 for TIM3 CH4 */

	/* using TIM DMA burst feature page 421 in Reference Manual 02-06-2018 */
	RCC_AHBPeriphClockCmd(RCC_AHBPeriph_DMA1, ENABLE);
	/* DMA ch3 receives the TIM3 Update event - page 281 in RM 02-06-2018 */
	DMA_DeInit(DMA1_Channel3);
	DMA_InitStructure->DMA_PeripheralBaseAddr = (uint32_t) &(TIM3->DMAR);
	DMA_InitStructure->DMA_MemoryBaseAddr =
			(uint32_t) ledstrip_transmit_dma_buffer;
	DMA_InitStructure->DMA_DIR = DMA_DIR_PeripheralDST;
	/*
	 * 24 bits need to determine the color of one led
	 * 3  there are 3 strips (ch2,ch3,ch4)
	 */
	DMA_InitStructure->DMA_BufferSize = DMA_BUFFER_SIZE;
	DMA_InitStructure->DMA_PeripheralInc = DMA_PeripheralInc_Disable;
	DMA_InitStructure->DMA_MemoryInc = DMA_MemoryInc_Enable;
	DMA_InitStructure->DMA_PeripheralDataSize = DMA_PeripheralDataSize_HalfWord;
	DMA_InitStructure->DMA_MemoryDataSize = DMA_MemoryDataSize_Byte;
	DMA_InitStructure->DMA_Mode = DMA_Mode_Circular;
	DMA_InitStructure->DMA_Priority = DMA_Priority_High;
	DMA_InitStructure->DMA_M2M = DMA_M2M_Disable;
	DMA_Init(DMA1_Channel3, DMA_InitStructure);

	TIM_DMAConfig(TIM3, TIM_DMABase_CCR2, TIM_DMABurstLength_3Transfers);
	TIM_DMACmd(TIM3, TIM_DMA_Update, ENABLE);
	DMA_ITConfig(DMA1_Channel3, DMA_IT_TC, ENABLE); /* transmission complete */
	DMA_ITConfig(DMA1_Channel3, DMA_IT_HT, ENABLE); /* half transfer complete */
}
