tardani95/esp8266-stm32f103c8-ws2811/(commit log)

2018-04-22 reading a button input and control a led
2018-04-22 led controll with a button - comments added
2018-04-22 gpio read with interrupt
    modifiing pc14, pc15 according to pb14 input
    the prell effect - need to be corrected
    [main.c]
2018-04-23 led control with interrupt
2018-04-24 ledstrip test - 800[kHz] - full 1 bit
2018-04-24 pwm line added for external interrupt detection
2018-04-24 pwm 16bit High 8bit Low - rising edge
2018-04-24 theoretical functioning pwm signal to the led
2018-04-25 preload register for timer enabled
2018-04-25 my ledstrip work on 400[kHz] frequency - works
2018-04-25 quick fix - fill up the unused led with zeros to see the change
    [main.c]
2018-04-26 test with 2 led strip - logic shifter needed
    led number, led to light up defines added
    by the end of the 2nd strip the color is changing - logic level shifter needed or/and better power supply needed
2018-04-26 look_up_table_added - it slips 1 step
    [main.c]
2018-04-26 slip fixed - lookup table converted to BRG values
    [main.c]
2018-04-26 function light_up_from-to added - flickers last ledif the color has blue
2018-04-30 uart init and first char readed the rest is not need to be fixed
    [main.c]
2018-04-30 stm32f103_ws2811 project pulled
2018-04-30 project compiling - updateing color according to the sent - todo: DMA
2018-04-30 test with two ledstrip
2018-05-05 the microprocessor drives two ledstrips parallel together on pb0,pb1
2018-05-05 prototype pcb design
    [ledsor.brd, ledsor.sch]
2018-05-23 uart gpio init function added - javadoc comments fixed
    [main.c]
2018-05-24 pcb images added
2018-05-30 uart rx mode changed to IPU - internal pull up
2018-05-30 dma irq handlers added
2018-05-30 empty dma irq handlers with description added
2018-05-30 header file includes updated - dma added
2018-05-30 nvic uart tx init function added
2018-05-30 init dma functions added
2018-05-31 usart tx functions with dma ch4 - issue: usart rx not working
    [main.c]
2018-06-01 uart with dma working - startup time set for esp8266 module
2018-06-01 timer3 dma init functions added
2018-06-01 timer3 with dma working
2018-06-02 multi channel pwm with dma basic functioning
2018-06-02 continously updating ledstrip
2018-06-16 dma interrupt function callbacks added
2018-06-16 dma request irq-s callback removed from interrupt include
2018-06-16 code cleanup and function pointer fix
    [main.c]
2018-06-17 debug purpose timer stopping functions added
2018-06-17 dma initialization function added
2018-06-17 timer initialization functions added
2018-06-18 ledstrip functions moved to ws2811 lib - works with some glitches
    [periph.c, periph.h, ws2811.c]
2018-06-18 dma handler moved to ws2811 lib
2018-06-18 uart array init moved here from main
2018-06-18 signal level high glitch fixed
    [ws2811.c]
2018-06-19 clear and fill up dma buffer functions added
2018-06-19 dma double buffering - this buffer size seems small
2018-06-19 issue - external interrupt callback called continously
    [main.c, ws2811.c]
2018-06-19 issue identified - buffer handling slow
    [ws2811.c]
2018-06-19 works with O3 optimization - init dma buffer function fix
    [ws2811.c, ws2811.h]
2018-06-19 works with optimization (O1, O2, O3, Og) - init dma buffer function fix
    [ws2811.c, ws2811.h]
2018-06-21 pixel frame explaining exel file
    [pixel_frame.xlsx]
2018-06-22 init dma buffer function fixed - init pixelmap function improved
    [ws2811.c]
2018-06-22 gamma correction turned on
    [ws2811.c]
2018-06-22 parallel ledstrip signal slip fix
    [ws2811.c, ws2811.h]
2018-06-23 new dma buffer fillup method
2018-06-24 getPixelColorHex() function and typo fix, dma buffer works with pixel_map
    [ws2811.c]
2018-06-25 typedef not found fixed
    [ws2811.c, ws2811.h, ws2811_util.c]
2018-06-25 millis and getsystickcount functions added
2018-06-25 strobe - ok, todo: bouncing balls need to be fixed
    [main.c]
2018-07-24 pcb design files added
    [schematic.brd, schematic.sch]
2018-07-24 webench boms, schematic and board designs added
    [bom_12v_3v3.xls, bom_12v_5v.xls]
2018-07-24 main parts added
    [schematic.brd, schematic.sch]
2018-07-24 mikrocontroller capacitances, boot pins, reset button added
    [schematic.brd, schematic.sch]
2018-07-26 xtal added and microcontroller pins connected - psu missing
    [schematic.sch]
2018-07-26 parts added, psu symbols fixed
    [schematic.brd, schematic.sch]
2018-07-27 psu 5v half ready
    [schematic.brd, schematic.sch]
2018-07-27 psu 5v and 3v3 ready
    [schematic.brd, schematic.sch]
2018-07-27 psu fixed
    [schematic.brd]
2018-07-27 final size set
    [schematic.brd]
2018-07-30 beta pcb - resistor values need to be calculated
    [schematic.brd, schematic.sch]
2018-07-30 gerber files exported
    [schematic.brd]
2018-07-30 Auto stash before merge of "pcb_design" and "origin/pcb_design"
2018-09-07 gerber files created, pcb arrived
    [copper_bottom.gbr, copper_top.gbr, drills.xln, gerber_job.gbrjob, profile.gbr, silkscreen_bottom.gbr, silkscreen_top.gbr, soldermask_bottom.gbr]
2018-09-25 electric parts arrived - pcb soldered
    [bom.xlsx, schematic.brd, schematic.sch]
2018-09-25 pcb tested - with 800kHz mode strip
2018-09-30 pcb fix - boot1 pin pulled to gnd
    [schematic.brd, schematic.sch]
2018-09-30 pcb fix - two more gnd polygon added
    [schematic.brd]
2018-10-14 pcb fixed - 2 wires were mixed up - bigger capacitance to SS pin
    [schematic.brd, schematic.sch]
2018-10-14 capacitor moved a bit
    [schematic.brd]
2018-10-14 gerber files added
2018-10-22 bom updated - pcb library updated
    [bom.xlsx, schematic.brd]
2018-10-23 prepairing for changing offset - length values per ledstrip
2018-11-05 pcb updated with leds
    [schematic.brd, schematic.sch]
2018-11-05 initial fill pattern replaced with initial color
    [main.c]
2018-11-25 ledstrip configuration updated - schematic attributes moved - libraries updated
    [schematic.sch]
2019-04-08 the blue and green values by the new ledstrip is exchanged
2019-04-17 multiple exti lines in irq not working
    [main.c, periph.c, ws2811.c, ws2811.h]
2019-04-17 pcb ground plane style changed to solid
    [schematic.brd]
2019-04-18 buttons IRQ handler moved to periph lib + array size initialization
